eberlawrence/bebionic_rebuild/Componentes prótese - Atualizado._v2.xlsx

Sheet: Principal
Componente | Características | Encapsulamento | Código | Posição | Quantidade | Quant. Total | Valor Unit. | Valor Total | Link | Total | $56.81479 | R$328.96
Microcontrolador | DSPIC33FJ128MC804 | 44-TQFP | DSPIC33FJ128MC804-I/PT | U4 | 1 | 5 | $5.82000 | $5.82000 | https://www.digikey.com/products/en?keywords=DSPIC33FJ128MC804-I%2FPT
Driver de Potência | A3906SESTR-T | 20-QFN | A3906SESTR-T | U2 | 1 | 25 | $1.65000 | $1.65000 | https://www.digikey.com/product-detail/en/allegro-microsystems/A3906SESTR-T/620-1288-1-ND/2000019
Conversor DC-DC | 3.3V / 1.5A | 16-QFN | TPS62111RSAT | U1 | 1 | 5 | $2.31000 | $2.31000 | https://www.digikey.com/product-detail/en/texas-instruments/TPS62111RSAT/296-20670-1-ND/1133730
Regulador de tensão | 5V / 500mA | SOT-23-5 | MIC5219-5.0YM5-TR | U7, U8 | 2 | 5 | $0.89000 | $1.78000 | https://www.digikey.com/product-detail/en/microchip-technology/MIC5219-5-0YM5-TR/576-2770-1-ND/1821930
Isolador I2C | ADUM1250 | 8-SOIC | ADUM1250SRZ-RL7 | U3 | 1 | 5 | $6.60000 | $6.60000 | https://www.digikey.com/product-detail/en/analog-devices-inc/ADUM1250SRZ-RL7/ADUM1250SRZ-RL7CT-ND/4909611
Amplificador Operacional | MCP601T-I/OTCT-ND | SOT-23-5 | MCP601T-I/OT | U5 | 1 | 25 | $0.39000 | $0.39000 | https://www.digikey.com/product-detail/en/microchip-technology/MCP601T-I-OT/MCP601T-I-OTCT-ND/418616
Amplificador Operacional Dual Channel | MCP6002T-I/SNCT-ND | 8-MSOP | MCP6002T-I/MS | U6 | 1 | 5 | $0.33000 | $0.33000 | https://www.digikey.com/product-detail/en/microchip-technology/MCP6002T-I-MS/MCP6002T-I-MSCT-ND/669500
Bluetooth | v5.0 | Nonstandard | BL651 | U9 | 1 | 5 | $5.10000 | $5.10000 | https://www.digikey.com/product-detail/en/laird-wireless-thermal-systems/453-00006/453-00006CT-ND/9608593
Mosfet-N | Vds:20V / Vgs(th): 950mV / Rds:175mOhms / Id: 1.24A | SOT-23 | DMN2300U-7 | Q2, Q3 | 2 | 10 | $0.44000 | $0.88000 | https://www.digikey.com/products/en?keywords=DMN2300U-7DICT-ND
Mosfet-N - Vm Swiching | Vds:20V / Vgs(th): 1.2V / Rds:350mOhms / 750mA | SOT-723 | NTK3134NT1G | Q7 | 1 | 5 | $0.47000 | $0.47000 | https://www.digikey.com/products/en?keywords=NTK3134NT1GOSCT-ND
Mosfet-N Dual Channel | Vds:20V / Vgs(th): 1V / Rds:100mOhms / Id: 2A | SOT-23-6 | DMN2215UDM-7 | Q1 | 1 | 5 | $0.53000 | $0.53000 | https://www.digikey.com/products/en?keywords=DMN2215UDMDICT-ND
Mosfet-P - High current | Vds:30V / Vgs(th): 950mV / Rds:13mOhms / Id: 11A | 8-SOIC | FDS6675BZ | Q9, Q88 | 2 | 10 | $0.60000 | $1.20000 | https://www.digikey.com/products/en?keywords=FDS6675BZCT-ND
Mosfet-P Dual Channel | Vds:20V / Vgs(th): 1V / Rds:150mOhms / Id: 2A | SOT-23-6 | DMP2240UDM-7 | Q4, Q5 | 2 | 10 | $0.40000 | $0.80000 | https://www.digikey.com/products/en?keywords=DMP2240UDMDICT-ND
Diodo | BAT54HT1GOSCT-ND | SOD-323 | BAT54HT1G | D2 | 1 | 5 | $0.20000 | $0.20000 | https://www.digikey.com/product-detail/en/on-semiconductor/BAT54HT1G/BAT54HT1GOSCT-ND/917809
Diodo Zener | 3.3V | SOD-323F | BZT52C3V3LP-7 | D1, D3 | 2 | 10 | $0.20000 | $0.40000 | https://www.digikey.com/product-detail/en/on-semiconductor/MM3Z3V3B/MM3Z3V3BCT-ND/1626881
Diodo Zener | 8.51V | DO-219AC | PLZ9V1A-G3/H | D33 | 1 | 5 | $0.28000 | $0.28000 | https://www.digikey.com/product-detail/en/vishay-semiconductor-diodes-division/PLZ9V1A-G3-H/PLZ9V1A-G3-HGICT-ND/8031857
Indutor | 6,8uH | 0806 | SRN2009T-6R8M | L3 | 1 | 5 | $0.39000 | $0.39000 | https://www.digikey.com/product-detail/en/SRN2009T-6R8M/SRN2009T-6R8MCT-ND/7785089/?itemSeq=327671345
Ferrite Beads | 30 Ohms @ 100MHz | 0805 | BLM21SN300SH1D | L1 | 1 | 5 | $0.19000 | $0.19000 | https://www.digikey.com/product-detail/en/BLM21SN300SH1D/490-13265-1-ND/5881265/?itemSeq=327671346
Capacitor | 10pF - 10V | 0402 | C0402C100C8GACTU | C7 | 1 | 10 | $0.34000 | $0.34000 | https://www.digikey.com/product-detail/en/kemet/C0402C100C8GACTU/399-8939-1-ND/3522456
Capacitor | 470pF - 10V | 0402 | C0402C471K8RACTU | C23, C24 | 2 | 20 | $0.42000 | $0.84000 | https://www.digikey.com/product-detail/en/kemet/C0402C471K8RACTU/399-10036-1-ND/3739531
Capacitor | 0,1uF - 10V | 0402 | C0402C104M8PACTU | C1, C2, C3, C4, C6, C8, C9, C12, C14, C15, C21, C27, C11 | 13 | 200* | $0.10000 | $1.30000 | https://www.digikey.com/product-detail/en/kemet/C0402C104M8PACTU/399-7764-1-ND/3471487
Capacitor | 1uF - 25V | 0402 | GRM155C81C105KE11D | C13, C17, C25, C26, C32 | 5 | 50 | $0.26000 | $1.30000 | https://www.digikey.com/product-detail/en/murata-electronics/GRM155C81C105KE11D/490-12700-1-ND/5797669
Capacitor | 2,2uF - 10V | 0402 | GRM155C81A225KE44D | C34, C35 | 2 | 20 | $0.29000 | $0.58000 | https://www.digikey.com/product-detail/en/murata-electronics/GRM155C81A225KE44D/490-10442-1-ND/5026349
Capacitor | 10uF - 25V | 0805 | GRM21BC81E106KE51K | C7, C10, C16, C20, C31 | 5 | 100* | $0.47000 | $2.35000 | https://www.digikey.com/product-detail/en/murata-electronics/GRM21BC81E106KE51K/490-16325-1-ND/7363307
Capacitor | 22uF - 10V | 0805 | GRT21BC81A226ME13L | C30 | 1 | 10 | $0.63000 | $0.63000 | https://www.digikey.com/product-detail/en/murata-electronics/GRT21BC81A226ME13L/490-12342-1-ND/5417043
Resistor | 33mOhms / 1% / 0,5W | 0805 | ERJ-6BWFR033V | R1 | 1 | 50 | $0.63000 | $0.63000 | https://www.digikey.com/product-detail/en/panasonic-electronic-components/ERJ-6BWFR033V/P-033AQCT-ND/1466383
Resistor | 100Ohms / 1% / 0,2W | 0402 | CRCW0402100RFKEDHP | R26 | 1 | 10 | $0.14000 | $0.14000 | https://www.digikey.com/product-detail/en/vishay-dale/CRCW0402100RFKEDHP/541-100YCT-ND/2223026
Resistor | 120Ohms / 1% / 0,2W | 0402 | ERJ-PA2F1200X | R7, R15 | 2 | 20 | $0.21000 | $0.42000 | https://www.digikey.com/product-detail/en/panasonic-electronic-components/ERJ-PA2F1200X/P124432CT-ND/10271408
Resistor | 470Ohms / 1% / 0,2W | 0402 | CRCW0402470RFKEDHP | R36 | 1 | 10 | $0.14000 | $0.14000 | https://www.digikey.com/product-detail/en/vishay-dale/CRCW0402470RFKEDHP/541-2938-1-ND/2825968
Resistor | 1KOhms / 1% / 0,2W | 0402 | RCS04021K00FKED | R3, R28, R37 | 3 | 30 | $0.11000 | $0.33000 | https://www.digikey.com/product-detail/en/vishay-dale/RCS04021K00FKED/541-2888-1-ND/5867181
Resistor | 2.2KOhms / 1% / 0,2W | 0402 | CRCW04022K20FKEDHP | R50 | 1 | 10 | $0.14000 | $0.14000 | https://www.digikey.com/product-detail/en/vishay-dale/CRCW04022K20FKEDHP/541-2-20KYCT-ND/5326785
Resistor | 4.7KOhms / 1% / 0,2W | 0402 | CRCW04024K70FKEDHP | R2, R8, R9, R11, R14, R34 | 6 | 100 | $0.14000 | $0.84000 | https://www.digikey.com/product-detail/en/vishay-dale/CRCW04024K70FKEDHP/541-4-70KYCT-ND/2223036
Resistor | 10KOhms / 1% / 0,2W | 0402 | CRCW040210K0FKEDHP | R6, R18, R27, R29, R30, R32, R33, R35, R42, R43, R44, R51, R54, R56, R57 | 15 | 400 | $0.14000 | $2.10000 | https://www.digikey.com/product-detail/en/vishay-dale/CRCW040210K0FKEDHP/541-10-0KYCT-ND/2223041
Resistor | 18KOhms / 1% / 0,2W | 0402 | CRCW040218K0FKEDHP | R10 | 1 | 100* | $0.14000 | $0.14000 | https://www.digikey.com/product-detail/en/vishay-dale/CRCW040218K0FKEDHP/CRCW040218K0FKEDHPCT-ND/2825955
Resistor | 27KOhms / 1% / 0,2W | 0402 | CRCW040227K0FKEDHP | R40, R41 | 2 | 20 | $0.14000 | $0.28000 | https://www.digikey.com/product-detail/en/vishay-dale/CRCW040227K0FKEDHP/541-CRCW040227K0FKEDHPCT-ND/11501115
Resistor | 39KOhms / 1% / 0,2W | 0402 | RCS040239K0FKED | R55 | 1 | 10 | $0.11000 | $0.11000 | https://www.digikey.com/product-detail/en/vishay-dale/RCS040239K0FKED/541-10406-1-ND/10059772
Resistor | 100KOhms / 1% / 0,2W | 0402 | CRCW0402100KFKEDHP | R46, R58 | 2 | 20 | $0.14000 | $0.28000 | https://www.digikey.com/product-detail/en/vishay-dale/CRCW0402100KFKEDHP/541-100KYCT-ND/2223051
Resistor | 191KOhms / 0,1% / 0,1W | 0402 | RP73PF1E191KBTD | R5 | 1 | 100* | $0.58000 | $0.58000 | https://www.digikey.com/product-detail/en/te-connectivity-passive-product/RP73PF1E191KBTD/A127538CT-ND/8261504
Resistor | 1MOhms / 1% / 0,2W | 0402 | CRCW04021M00FKEDHP | R49 | 1 | 10 | $0.14000 | $0.14000 | https://www.digikey.com/product-detail/en/vishay-dale/CRCW04021M00FKEDHP/541-1-00MYCT-ND/2224560
Conector F. | NSHR-02V-S |  |  | J5, J6, J10 | 3 |  | $0.17000 | $0.51000 | https://www.digikey.com/products/en?keywords=NSHR-02V-S
Conector F. | NSHR-06V-S |  |  | J1, J2, J3, J4, J7, J9 | 6 |  | $0.24000 | $1.44000 | https://www.digikey.com/products/en?keywords=NSHR-06V-S
Conector F. | NSHR-04V-S |  |  | J8 | 1 |  | $0.21000 | $0.21000 | https://www.digikey.com/product-detail/en/jst-sales-america-inc/NSHR-04V-S/455-2790-ND/3313614
Conector M. | SM02B-NSHSS-TB |  |  | J5, J6, J10 | 3 |  | $0.36525 | $1.09575 | https://www.digikey.com/product-detail/en/jst-sales-america-inc/SM02B-NSHSS-TB-LF-SN/455-2776-2-ND/3313627
Conector M. | SM06B-NSHSS-TB (LF)(SN) |  |  | J1, J4, J7, J9 | 4 |  | $0.93000 | $3.72000 | https://www.digikey.com/product-detail/en/jst-sales-america-inc/SM06B-NSHSS-TB-LF-SN/455-2772-1-ND/3313667
Conector M. | SM04B-NSHSS-TB (LF)(SN) |  |  | J8 | 1 |  | $0.87000 | $0.87000 | https://www.digikey.com/product-detail/en/jst-sales-america-inc/SM04B-NSHSS-TB-LF-SN/455-2774-1-ND/3313665
Conector M. | BM06B-NSHSS-TBT (LF)(SN) |  |  | J2, J3 | 2 |  | $0.48952 | $0.97904 | https://www.digikey.com/product-detail/en/jst-sales-america-inc/BM06B-NSHSS-TBT-LF-SN/455-2758-2-ND/3313646
Terminal C. | SSHL-003T-P0.2 |  |  | J1, J2, J3, J4, J5, J6, J7, J8, J9, J10 | 46 |  | $0.11000 | $5.06000 | https://www.digikey.com/product-detail/en/jst-sales-america-inc/SSHL-003T-P0-2/455-2792-1-ND/3313668

Sheet: Novos conectores
Conector M. | 5015680207 | 2 pins | J5, J6, J10 | 3 | $0.51000 | $1.53000 | https://www.digikey.com/product-detail/en/molex/5015680207/WM7893CT-ND/1531543
Conector M. | 5015680607 | 6 pins | J1, J2, J3, J4, J7, J9 | 6 | $0.77000 | $4.62000 | https://www.digikey.com/product-detail/en/molex/5015680607/WM7897CT-ND/1531547
Conector M. | 5015680407 | 4 pins | J8 | 1 | $0.55000 | $0.55000 | https://www.digikey.com/product-detail/en/molex/5015680407/WM7895CT-ND/1531545
Conector F. | 5013300200 | 2 pins | J5, J6, J10 | 3 | $0.27000 | $0.81000 | https://www.digikey.com/products/en?keywords=5013300200
Conector F. | 5013300400 | 4 pins | J8 | 1 | $0.27000 | $0.27000 | https://www.digikey.com/product-detail/en/molex/5013300400/WM7917-ND/1531501
Conector F. | 5013300600 | 6 pins | J1, J2, J3, J4, J7, J9 | 6 | $0.29000 | $1.74000 | https://www.digikey.com/products/en?keywords=5013300600
Terminal | 5013340100 |  | J1, J2, J3, J4, J5, J6, J7, J8, J9, J10 | 46 | $0.11000 | $5.06000 | https://www.digikey.com/product-detail/en/molex/5013340100/WM7933-ND/1531513

Sheet: Motor
Componente | Espe | Encapsulamento | Código | Posição | Quantidade | Valor Unit. | Valor Total | Link | Total | $10.00000 | R$57.90
Microcontrolador | DSPIC33FJ32MC202 | 28-QFN-S | DSPIC33FJ32MC202T-I/MM | U1 | 1 | $3.78000 | $3.78000 | https://www.digikey.com/products/en/integrated-circuits-ics/embedded-microcontrollers/685?k=DSPIC33FJ32MC202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
Driver de Potência | A3906SESTR-T | 20-QFN | A3906SESTR-T | U2 | 1 | $1.65000 | $1.65000 | https://www.digikey.com/product-detail/en/allegro-microsystems/A3906SESTR-T/620-1288-1-ND/2000019
Amplificador Operacional | MCP601T-I/OTCT-ND | SOT-23-5 | MCP601T-I/OT | U3 | 1 | $0.39000 | $0.39000 | https://www.digikey.com/product-detail/en/microchip-technology/MCP601T-I-OT/MCP601T-I-OTCT-ND/418616
Capacitor | 10uF - 25V | 0805 | GRM21BC81E106KE51K | C6, C7 | 2 | $0.47000 | $0.94000 | https://www.digikey.com/product-detail/en/murata-electronics/GRM21BC81E106KE51K/490-16325-1-ND/7363307
Capacitor | 0,1uF - 10V | 0402 | C0402C104M8PACTU | C1, C2, C5, C6, C9, C10, C11, C12, C13, C14, C15 | 13 | $0.10000 | $1.30000 | https://www.digikey.com/product-detail/en/kemet/C0402C104M8PACTU/399-7764-1-ND/3471487
Resistor | 33mOhms / 1% / 0,5W | 0805 | ERJ-6BWFR033V | R6 | 1 | $0.63000 | $0.63000 | https://www.digikey.com/product-detail/en/panasonic-electronic-components/ERJ-6BWFR033V/P-033AQCT-ND/1466383
Resistor | 4.7KOhms / 1% / 0,2W | 0402 | CRCW04024K70FKEDHP | R7 | 1 | $0.14000 | $0.14000 | https://www.digikey.com/product-detail/en/vishay-dale/CRCW04024K70FKEDHP/541-4-70KYCT-ND/2223036
Resistor | 10KOhms / 1% / 0,2W | 0402 | CRCW040210K0FKEDHP | R1, R2, R5, R18, R30 | 5 | $0.14000 | $0.70000 | https://www.digikey.com/product-detail/en/vishay-dale/CRCW040210K0FKEDHP/541-10-0KYCT-ND/2223041
Resistor | 18KOhms / 1% / 0,2W | 0402 | CRCW040218K0FKEDHP | R4 | 1 | $0.14000 | $0.14000 | https://www.digikey.com/product-detail/en/vishay-dale/CRCW040218K0FKEDHP/CRCW040218K0FKEDHPCT-ND/2825955
Resistor | 191KOhms / 0,1% / 0,1W | 0402 | RP73PF1E191KBTD | R3 | 1 | $0.58000 | $0.58000 | https://www.digikey.com/product-detail/en/te-connectivity-passive-product/RP73PF1E191KBTD/A127538CT-ND/8261504
Conector F. | NSHR-06V-S |  |  | J1, J2 | 2 | $0.24000 | $0.48000 | https://www.digikey.com/products/en?keywords=NSHR-06V-S
Conector F. | NSHR-04V-S |  |  | J3 | 1 | $0.21000 | $0.21000 | https://www.digikey.com/product-detail/en/jst-sales-america-inc/NSHR-04V-S/455-2790-ND/3313614
Conector M. | SM06B-NSHSS-TB (LF)(SN) |  |  | J1, J2 | 2 | $0.93000 | $1.86000 | https://www.digikey.com/product-detail/en/jst-sales-america-inc/SM06B-NSHSS-TB-LF-SN/455-2772-1-ND/3313667
Conector M. | SM04B-NSHSS-TB (LF)(SN) |  |  | J3 | 1 | $0.87000 | $0.87000 | https://www.digikey.com/product-detail/en/jst-sales-america-inc/SM04B-NSHSS-TB-LF-SN/455-2774-1-ND/3313665
Terminal C. | SSHL-003T-P0.2 |  |  | J1, J2, J3 | 16 | $0.11000 | $1.76000 | https://www.digikey.com/product-detail/en/jst-sales-america-inc/SSHL-003T-P0-2/455-2792-1-ND/3313668
