eberlawrence/bebionic_rebuild/bebionic_shc-brd/Placa_Motor_Protese (1).pdf

A

A

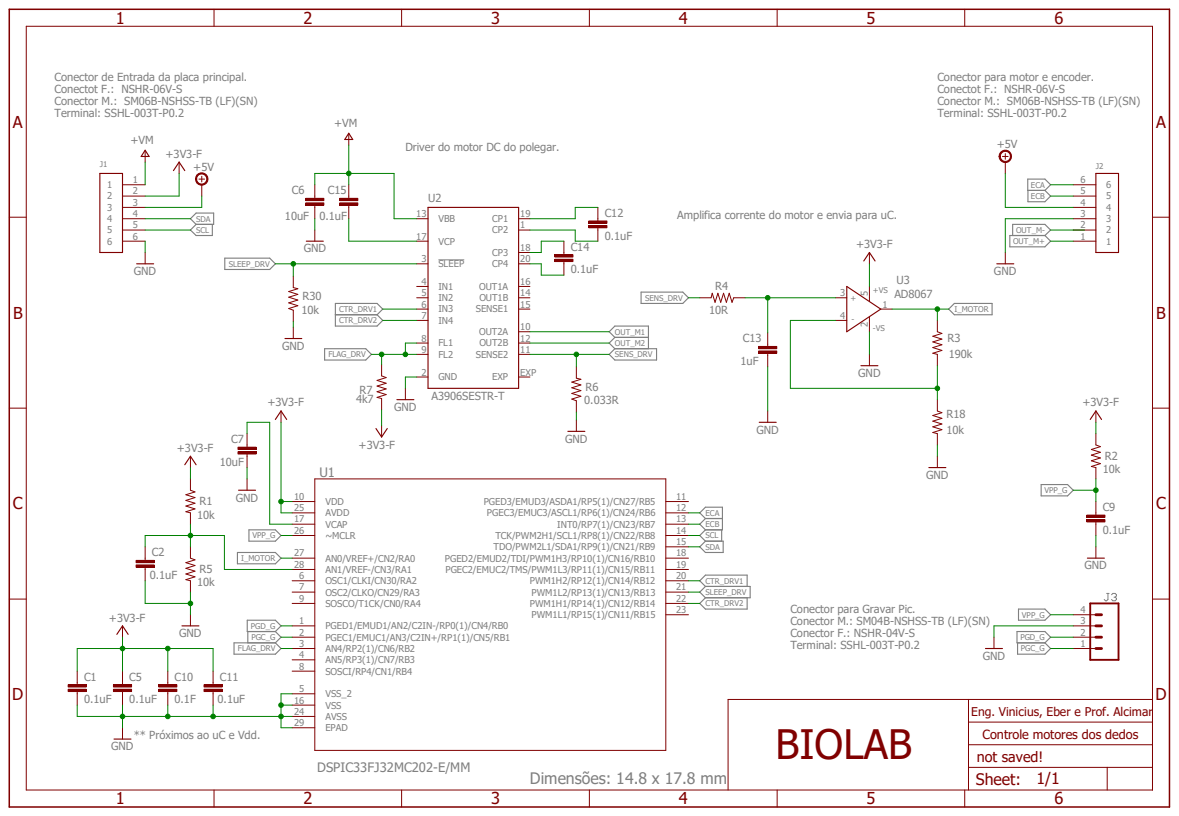
[picture p8: page 1]

Conector de Entrada da placa principal.
Conectot F.: NSHR-06V-S
Conector M.: SM06B-NSHSS-TB (LF)(SN)
Terminal: SSHL-003T-P0.2

Conector para motor e encoder.

Driver do motor DC do polegar.

Amplifica corrente do motor e envia para uC.

Conector para Gravar Pic.
Conector M.: SM04B-NSHSS-TB (LF)(SN)
Conector F.: NSHR-04V-S
BIOLAB

Eng. Vinicius, Eber e Prof. Alcimar
Controle motores dos dedos
not saved!
Sheet:

** Próximos ao uC e Vdd.
GND
