eberlawrence/bebionic_rebuild/bebionic_shc-brd/finger_circuit.pdf

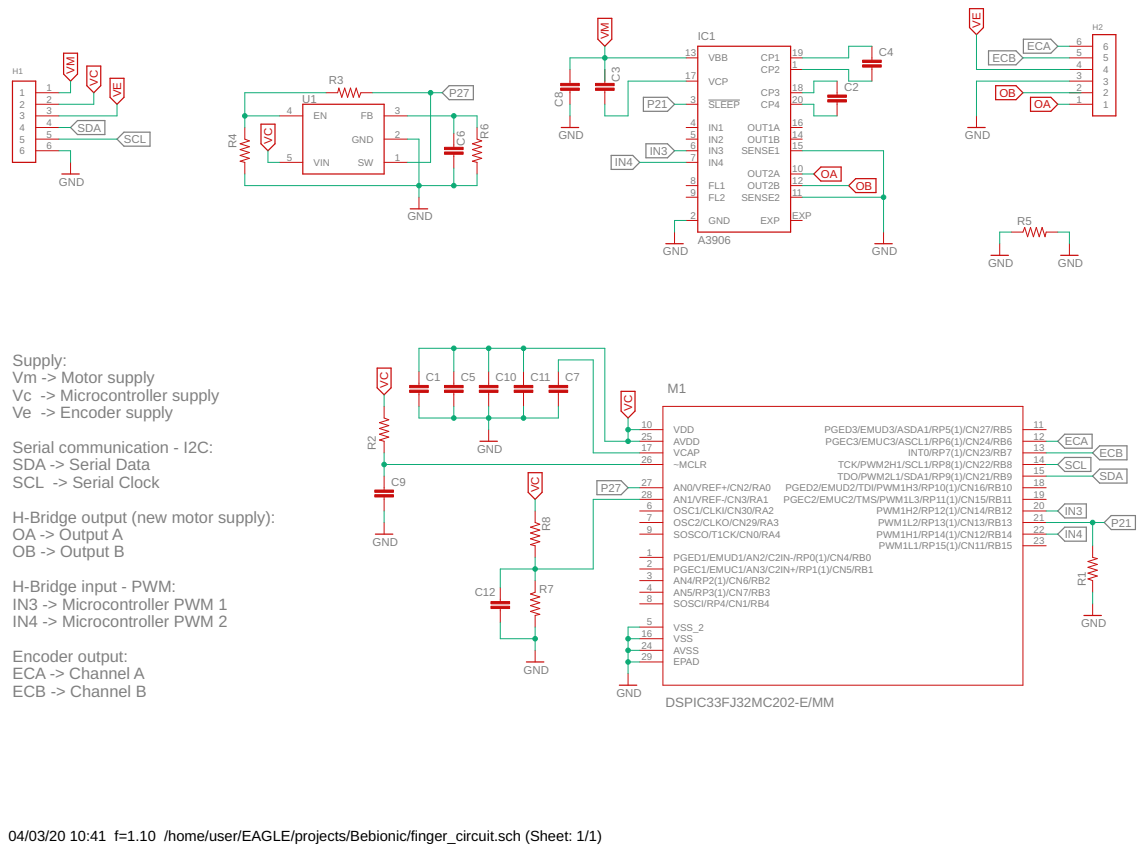
[picture p9: page 1]

H-Bridge output (new motor supply):
OA -> Output A
OB -> Output B

04/03/20 10:41 f=1.10 /home/user/EAGLE/projects/Bebionic/finger_circuit.sch (Sheet: 1/1)
