eberlawrence/bebionic_rebuild/bebionic_shc-brd/main_circuit.pdf

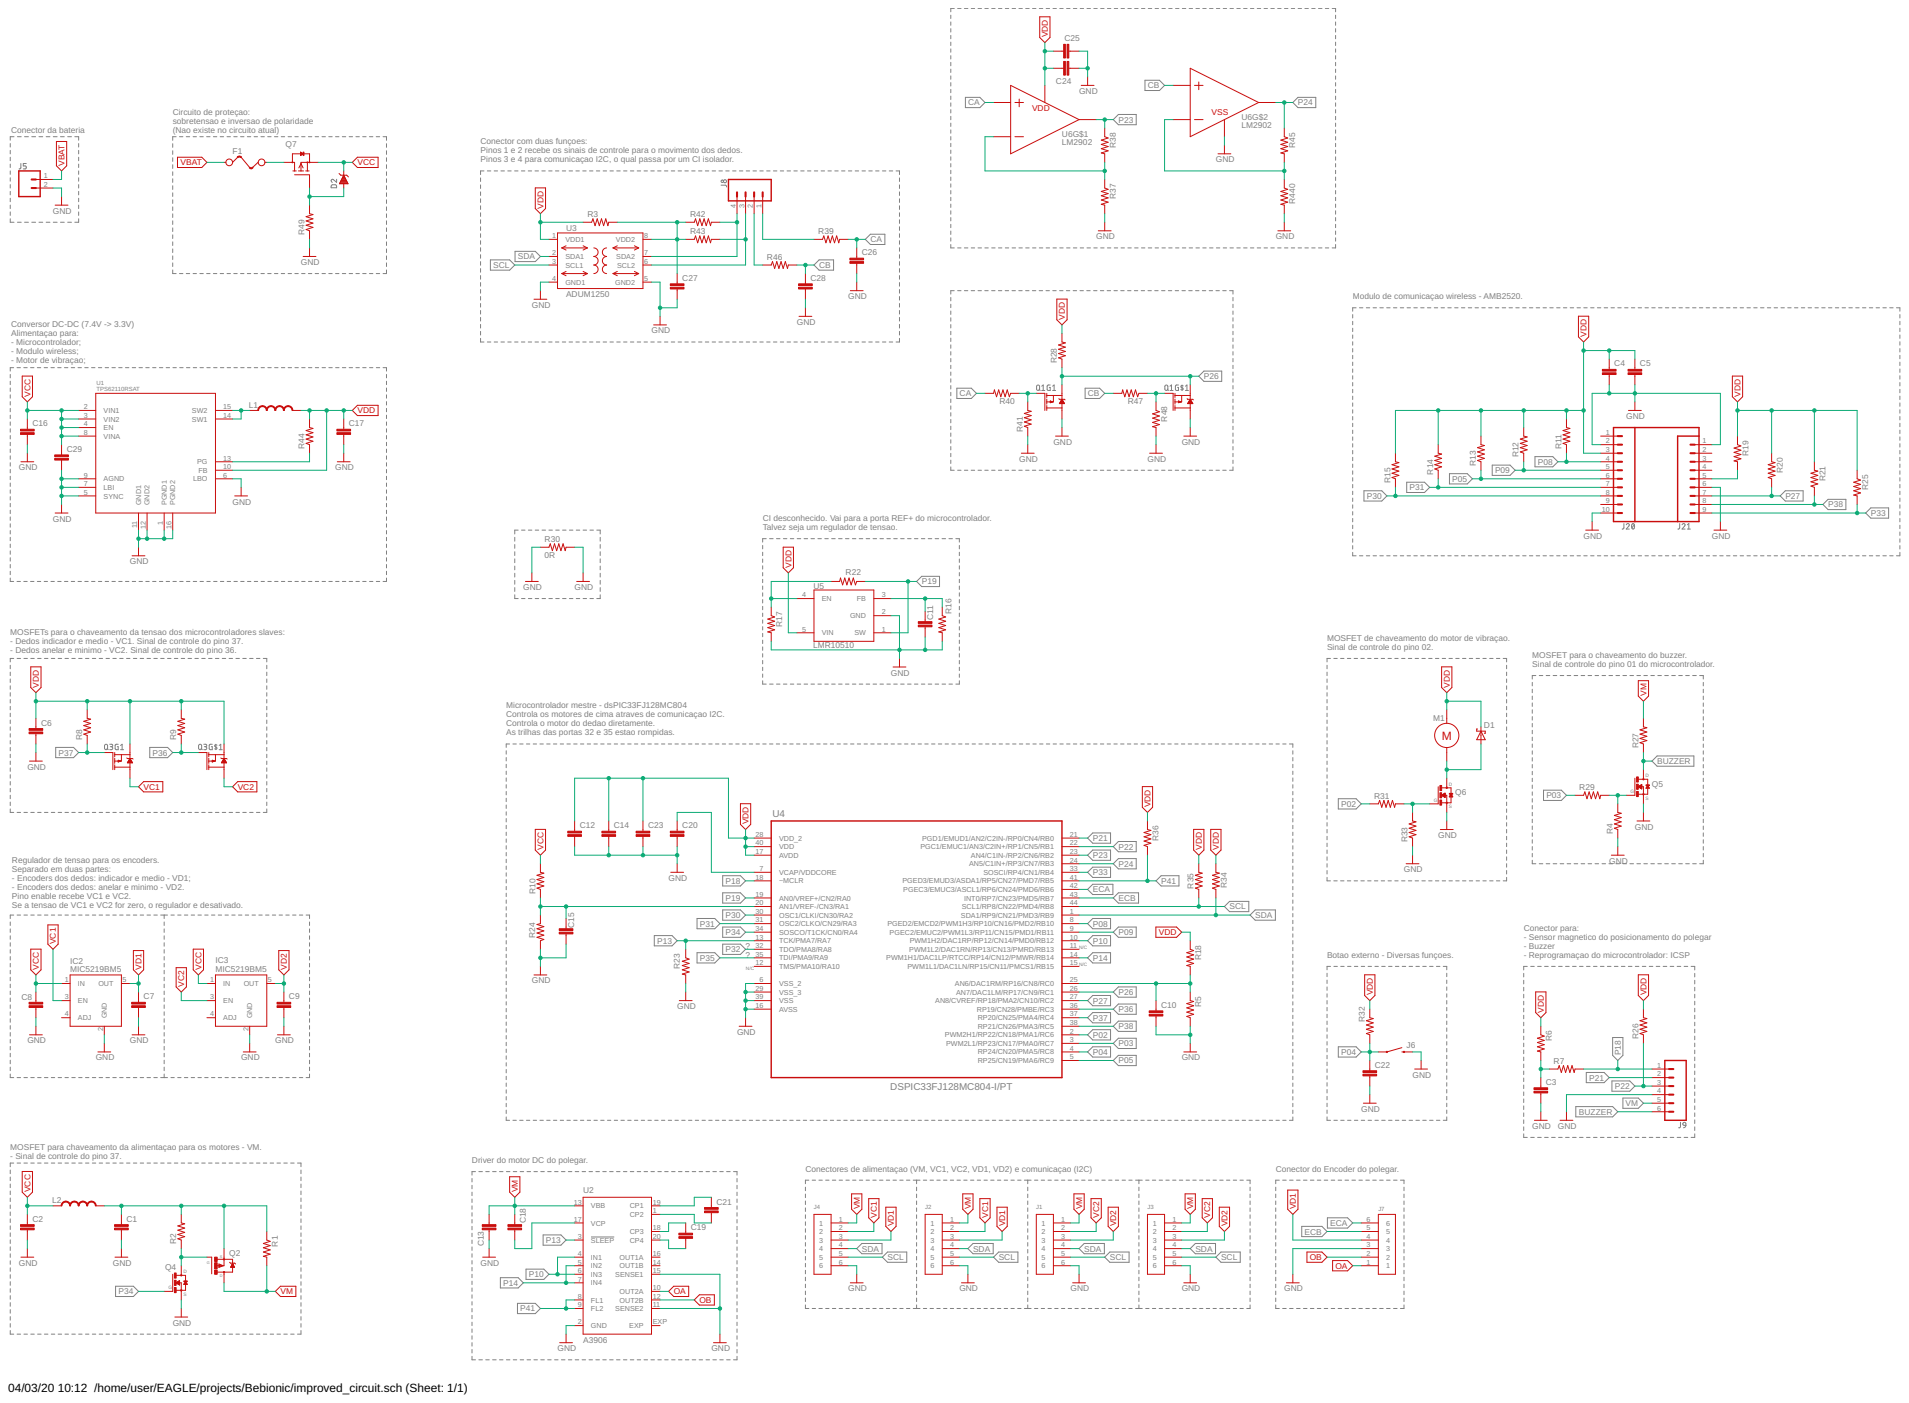
[picture p10: page 1]

(Nao existe no circuito atual)

Conector com duas funçoes: Pinos 1 e 2 recebe os sinais de controle para o movimento dos dedos. Pinos 3 e 4 para comunicaçao I2C, o qual passa por um CI isolador.

Modulo de comunicaçao wireless - AMB2520.

Conversor DC-DC (7.4V -> 3.3V)
Alimentaçao para: - Microcontrolador; - Modulo wireless; - Motor de vibraçao;

CI desconhecido. Vai para a porta REF+ do microcontrolador. Talvez seja um regulador de tensao.

MOSFETs para o chaveamento da tensao dos microcontroladores slaves: - Dedos indicador e medio - VC1. Sinal de controle do pino 37. - Dedos anelar e minimo - VC2. Sinal de controle do pino 36.

MOSFET de chaveamento do motor de vibraçao. Sinal de controle do pino 02.

MOSFET para o chaveamento do buzzer. Sinal de controle do pino 01 do microcontrolador.

Microcontrolador mestre - dsPIC33FJ128MC804
Controla os motores de cima atraves de comunicaçao I2C. Controla o motor do dedao diretamente. As trilhas das portas 32 e 35 estao rompidas.

Regulador de tensao para os encoders. Separado em duas partes: - Encoders dos dedos: indicador e medio - VD1; - Encoders dos dedos: anelar e minimo - VD2. Pino enable recebe VC1 e VC2. Se a tensao de VC1 e VC2 for zero, o regulador e desativado.

P31 | P08
P34 | P09

Conector para: - Sensor magnetico do posicionamento do polegar
- Buzzer
- Reprogramaçao do microcontrolador: ICSP

Botao externo - Diversas funçoes.

MOSFET para chaveamento da alimentaçao para os motores - VM. - Sinal de controle do pino 37.

Driver do motor DC do polegar.

04/03/20 10:12 /home/user/EAGLE/projects/Bebionic/improved_circuit.sch (Sheet: 1/1)
