eberlawrence/bebionic_rebuild/bebionic_shc-brd/Placa_Main_Protese (1).pdf

# FDN352AP12k

A

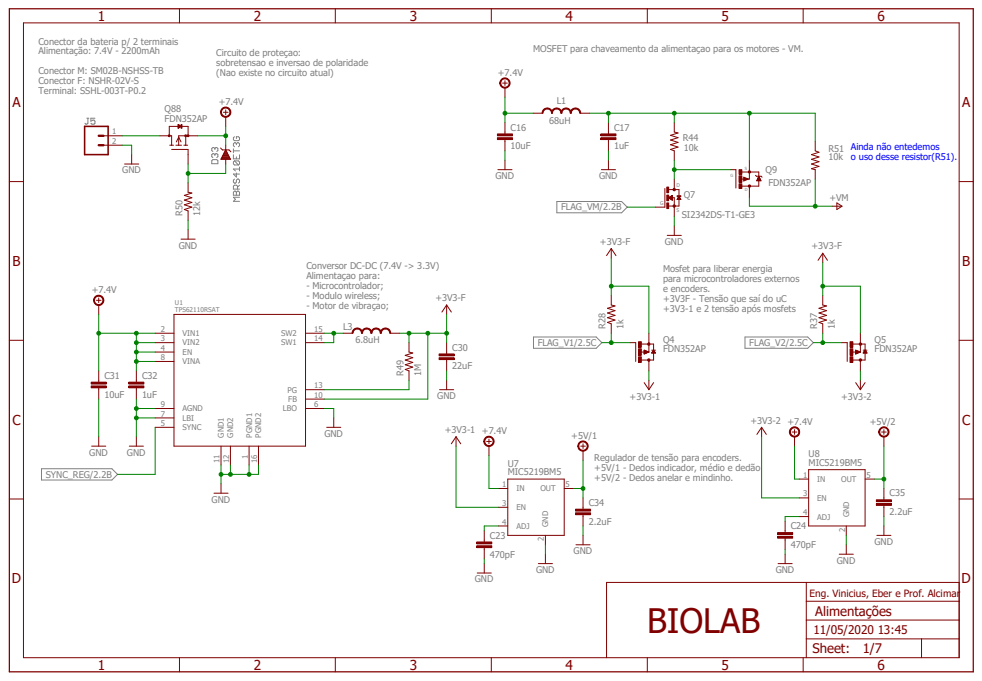
[picture p11: page 1]

Conector da bateria p/ 2 terminais
Alimentação: 7.4V - 2200mAh
Conector M: SM02B-NSHSS-TB
Conector F: NSHR-02V-S
Terminal: SSHL-003T-P0.2

Circuito de proteçao:
sobretensao e inversao de polaridade
(Nao existe no circuito atual)

MOSFET para chaveamento da alimentaçao para os motores - VM.

Mosfet para liberar energia
para microcontroladores externos
e encoders.
+3V3F - Tensão que saí do uC
+3V3-1 e 2 tensão após mosfets

Regulador de tensão para encoders.
+5V/1 - Dedos indicador, médio e dedão
+5V/2 - Dedos anelar e mindinho.

A

A

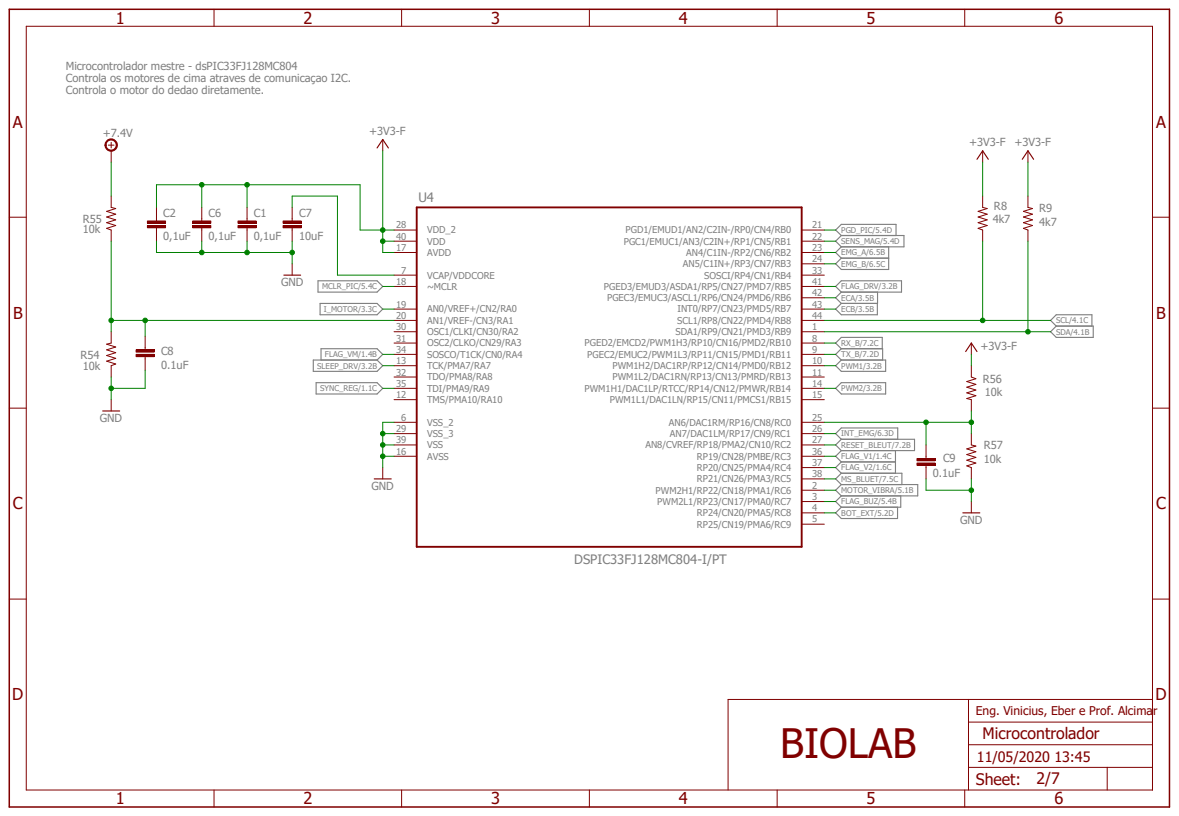
[picture p12: page 2]

Microcontrolador mestre - dsPIC33FJ128MC804
Controla os motores de cima atraves de comunicaçao I2C.
Controla o motor do dedao diretamente.

A

A

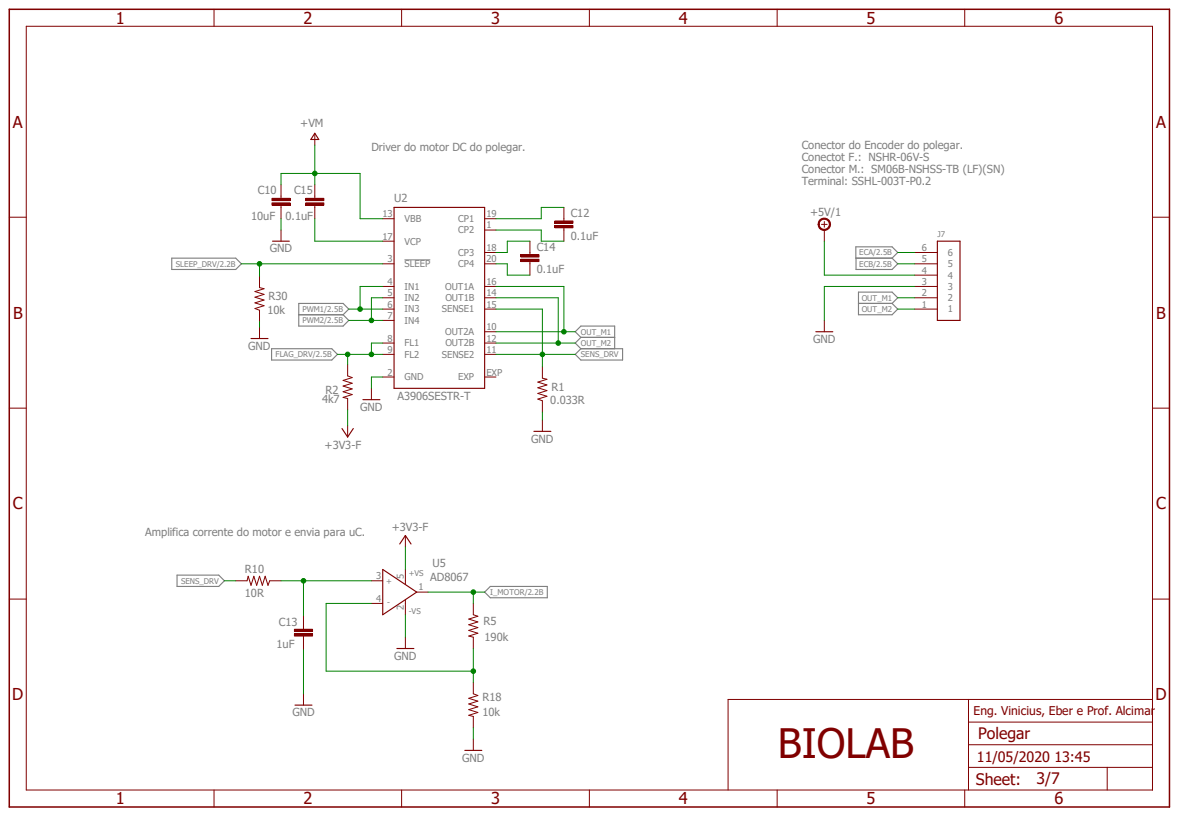
[picture p13: page 3]

Conectot F.: NSHR-06V-S
Conector M.: SM06B-NSHSS-TB (LF)(SN)
Terminal: SSHL-003T-P0.2

Amplifica corrente do motor e envia para uC.

A

A

Saída Dedo indicador; Saída Dedo Médio; Saída Dedo Anelar; Saída Dedo Mindinho; GND; SCL/6.1B; SDA/6.1B; BIOLAB

Conector dos dedos.
Conectot F.: NSHR-06V-S
Conector M.: SM06B-NSHSS-TB (LF)(SN)
Terminal: SSHL-003T-P0.2

Eng. Vinicius, Eber e Prof. Alcimar
Demais dedos
Sheet:

A

A

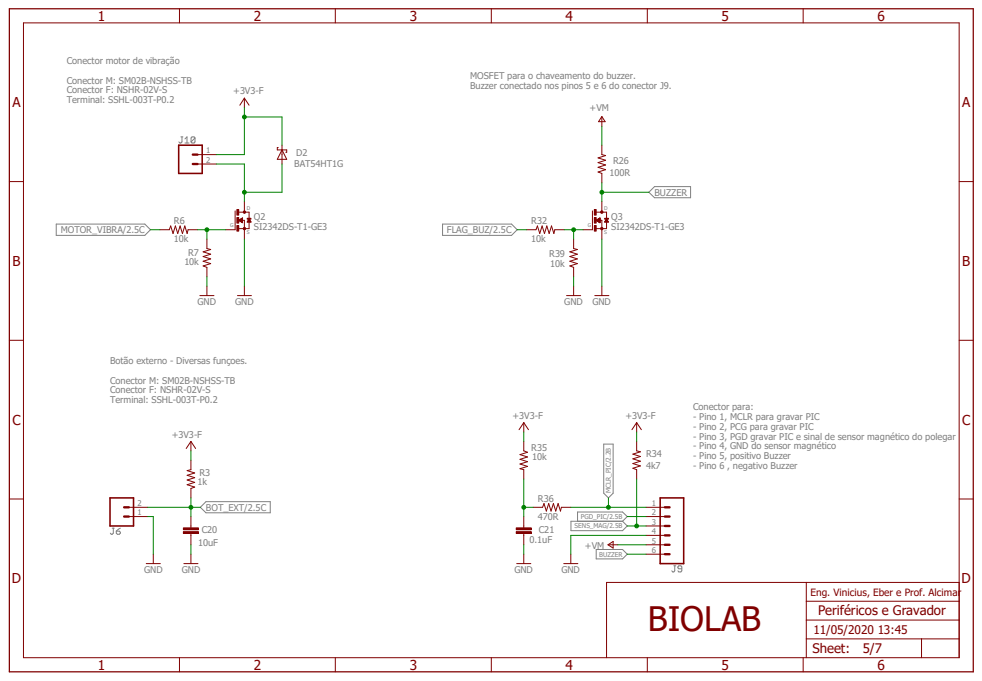
[picture p14: page 5]

Conector motor de vibração
Conector M: SM02B-NSHSS-TB
Conector F: NSHR-02V-S
Terminal: SSHL-003T-P0.2

MOSFET para o chaveamento do buzzer.
Buzzer conectado nos pinos 5 e 6 do conector J9.

Botão externo - Diversas funçoes.

- Pino 1, MCLR para gravar PIC
- Pino 2, PCG para gravar PIC
- Pino 3, PGD gravar PIC e sinal de sensor magnético do polegar
- Pino 4, GND do sensor magnético
- Pino 5, positivo Buzzer
- Pino 6 , negativo Buzzer

Eng. Vinicius, Eber e Prof. Alcimar
Periféricos e Gravador
Sheet:

A

A

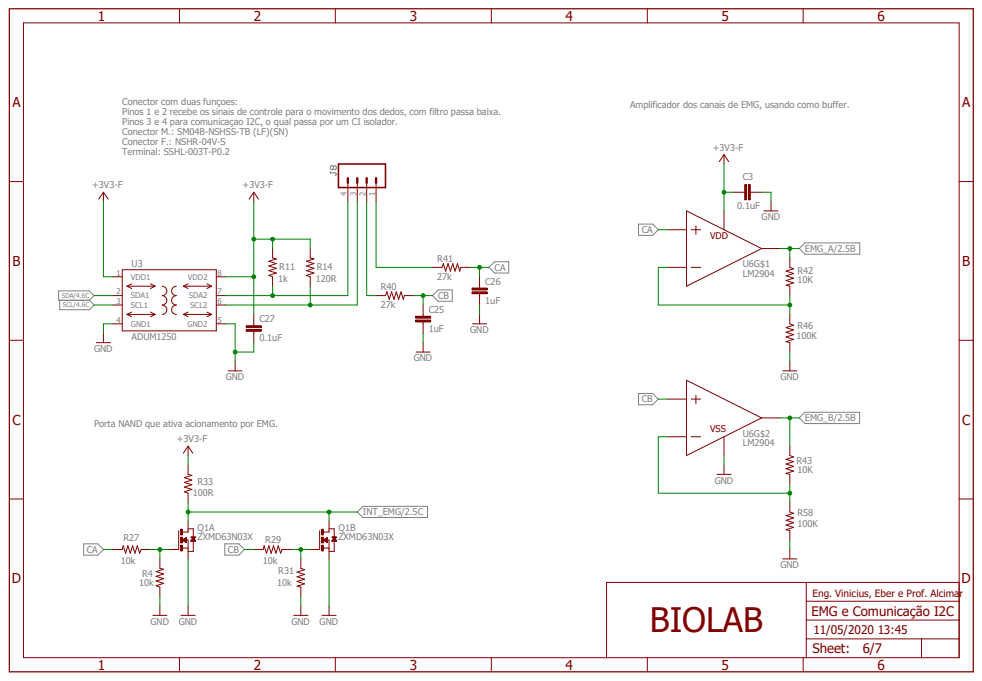
[picture p15: page 6]

Conector com duas funçoes:
Pinos 1 e 2 recebe os sinais de controle para o movimento dos dedos, com filtro passa baixa.
Pinos 3 e 4 para comunicaçao I2C, o qual passa por um CI isolador.
Conector M.: SM04B-NSHSS-TB (LF)(SN)
Conector F.: NSHR-04V-S
Terminal: SSHL-003T-P0.2

Amplificador dos canais de EMG, usando como buffer.

Porta NAND que ativa acionamento por EMG.

Eng. Vinicius, Eber e Prof. Alcimar
EMG e Comunicação I2C
Sheet:

A

A

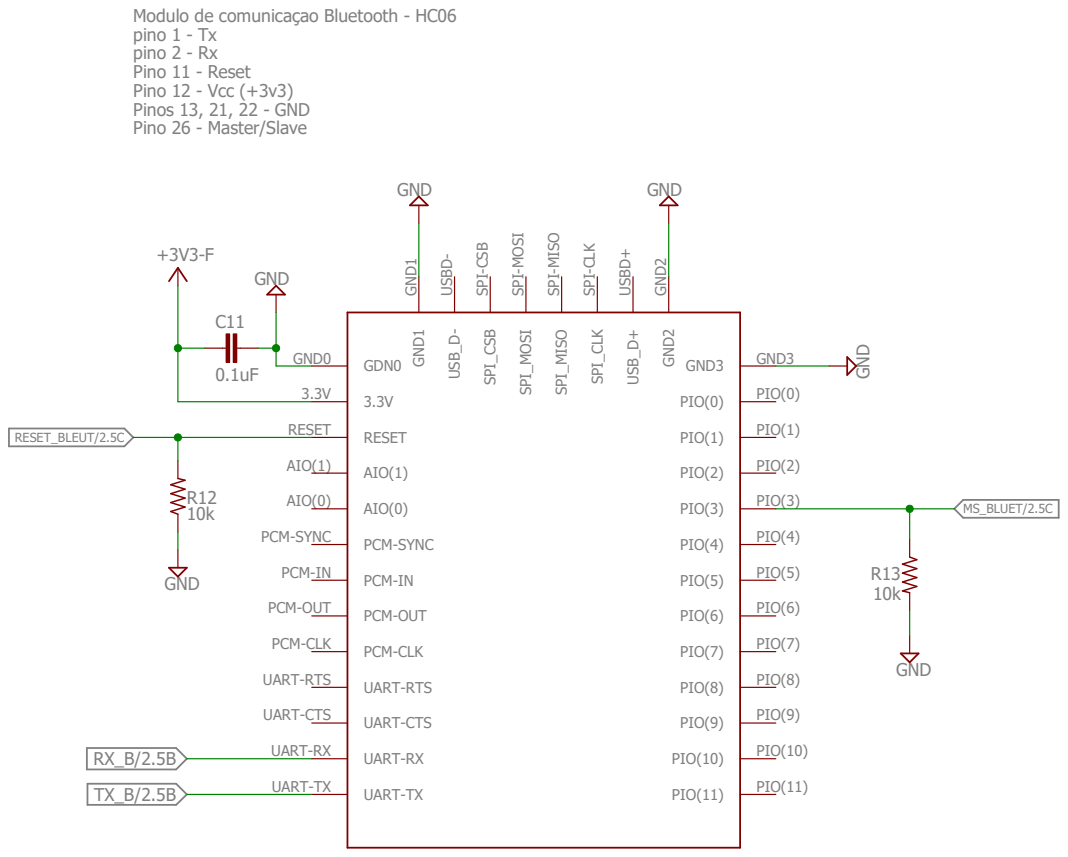
[picture p16: page 7]
GND; AIO(0) AIO(0); AIO(1) AIO(1); RESET RESET; GDN0 GND0; GND¹ GND¹; USB_D⁻ USBD⁻; SPI_CSB SPI-CSB; SPI_MOSI SPI-MOSI; SPI_MISO SPI-MISO; SPI_CLK SPI-CLK; USB_D+ USBD+; GND² GND²; GND3; PIO(0); PIO(1); PIO(2); PIO(3); PIO(4); PIO(5); PIO(6); PIO(7); PIO(8); PIO(9); PIO(10); PIO(11); RESET_BLEUT/2.5C; MS_BLUET/2.5C; BIOLAB

Modulo de comunicaçao Bluetooth - HC06
pino 1 - Tx
pino 2 - Rx
Pino 11 - Reset
Pino 12 - Vcc (+3v3)
Pinos 13, 21, 22 - GND
Pino 26 - Master/Slave

PCM-SYNC

PCM-IN

PCM-OUT

PCM-CLK

UART-RTS

UART-CTS

UART-RX

UART-TX

Eng. Vinicius, Eber e Prof. Alcimar
Bluetooth
Sheet:
