eberlawrence/bebionic_rebuild/(list of files, drawings)

Other design files:
bebionic_simulation/bebionic_simulation.pdsprj
bebionic_simulation/final_simulation.pdsprj
bebionic_simulation/only_master.pdsprj
bebionic_simulation/only_master_copy.pdsprj
