eberlawrence/bebionic_rebuild/Bebionic_Final_backup/placa_motor_v5.brd

## EAGLE design Bebionic_Final_backup/placa_motor_v5.brd (2021-04-02)

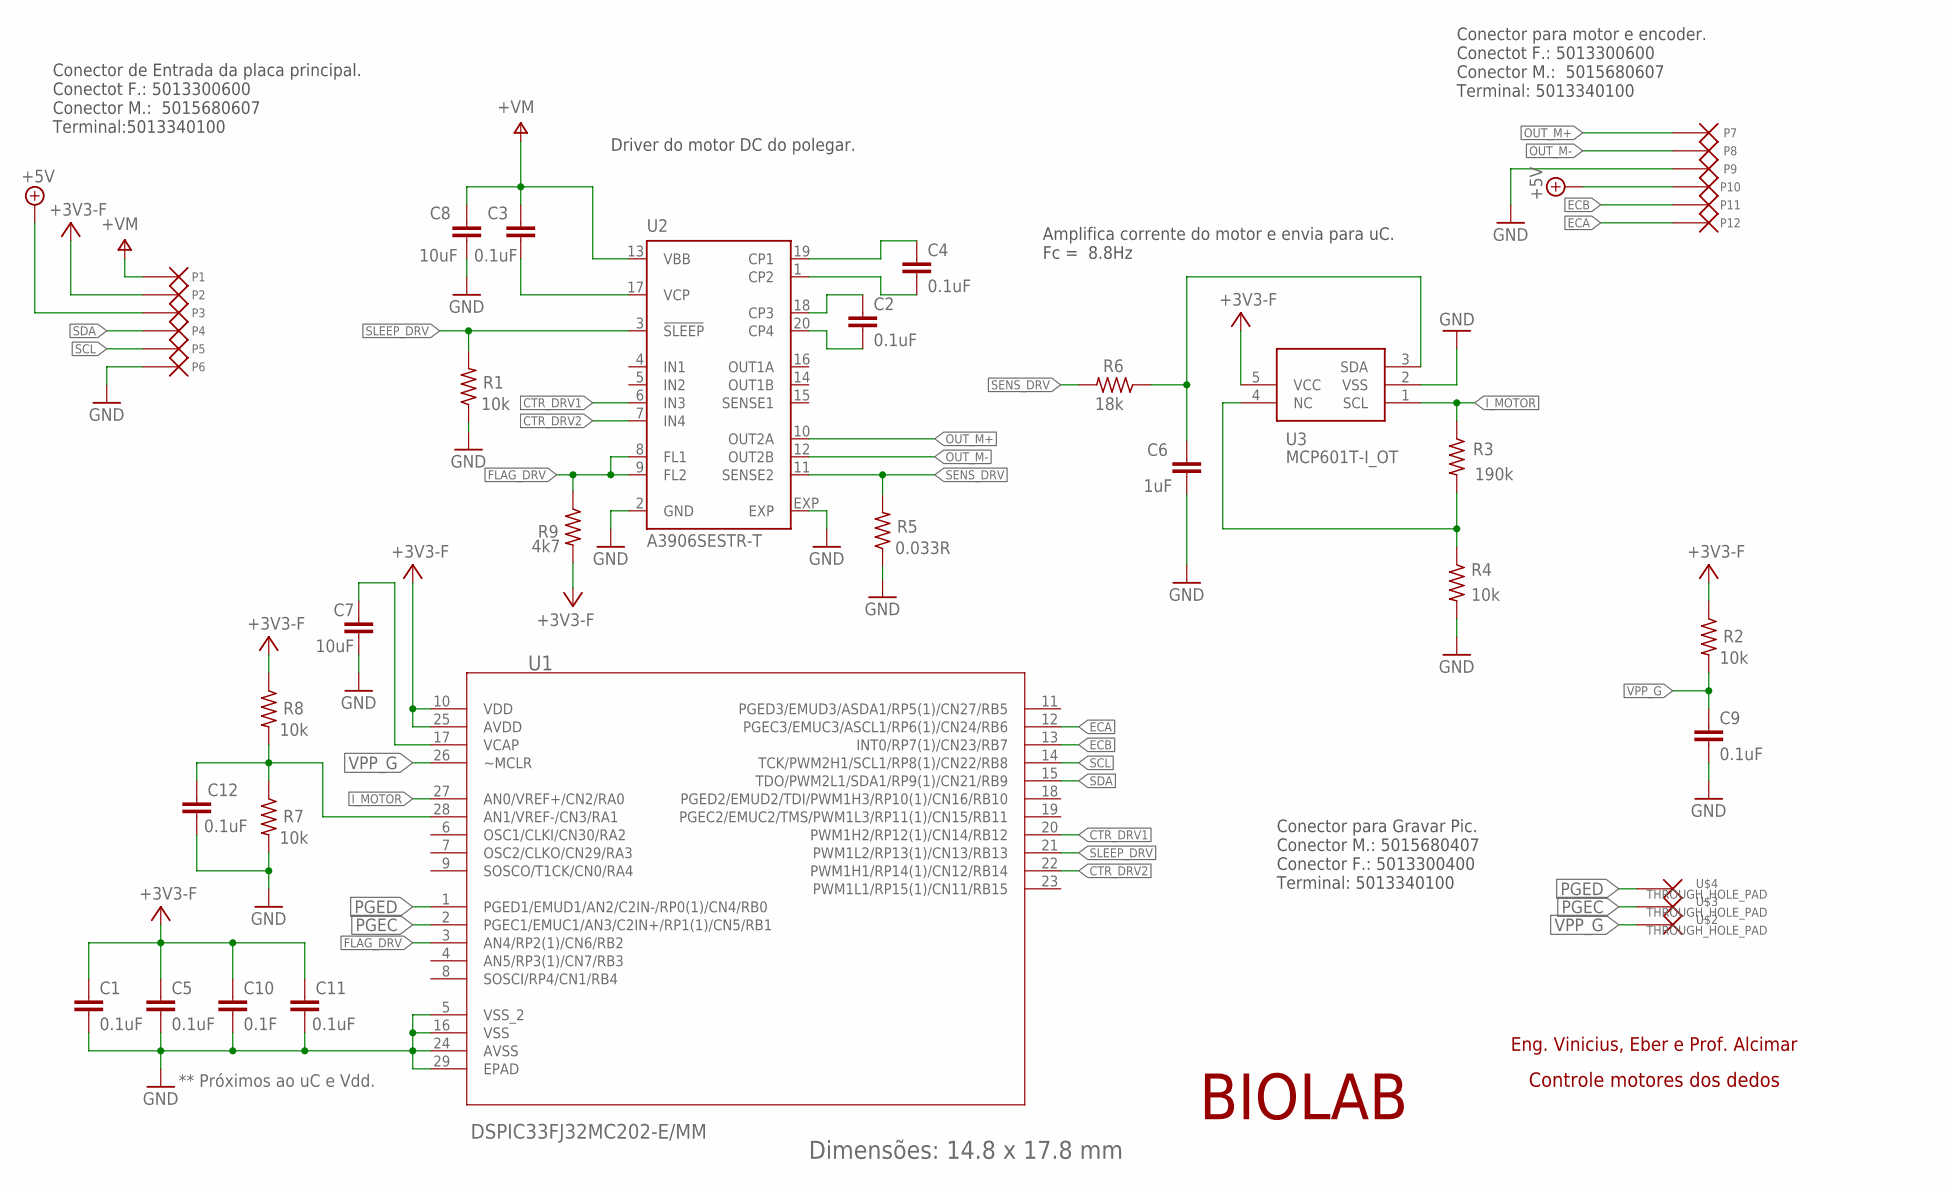
[picture p17: schematic placa_motor_v5.sch]

Parts:
C1, C2, C3, C4, C5, C9, C11, C12: 0.1uF; C0402K
C6: 1uF; C0402K
C7, C8: 10uF; C0805K
C10: 0.1F; C0402K
P1, P2, P3, P4, P5, P6, P7, P8, P9, P10, P11, P12: THROUGH_HOLE_PAD
R1, R2, R4, R7, R8: 10k; R0402
R3: 190k; R0402
R5: 0.033R; R0805
R6: 18k; R0402
R9: 4k7; R0402
U1: DSPIC33FJ32MC202-E/MM; QFN65P600X600X100-29N
U2: A3906SESTR-T; QFN20
U3: MCP601T-I_OT; SOT95P270X145-5N
U$2, U$3, U$4: THROUGH_HOLE_PAD

Connections:
+3V3: C1.1, C5.1, C10.1, C11.1, P2.P$1, R2.1, R8.1, R9.2, U1.10 (VDD), U1.25 (AVDD), U3.5 (VCC)
+5V: P3.P$1, P10.P$1
AUX: C12.1, R7.1, R8.2, U1.28 (AN1/VREF-/CN3/RA1)
CTR_DRV1: U1.20 (PWM1H2/RP12(1)/CN14/RB12), U2.6 (IN3)
CTR_DRV2: U1.22 (PWM1H1/RP14(1)/CN12/RB14), U2.7 (IN4)
ECA: P12.P$1, U1.12 (PGEC3/EMUC3/ASCL1/RP6(1)/CN24/RB6)
ECB: P11.P$1, U1.13 (INT0/RP7(1)/CN23/RB7)
FLAG_DRV: R9.1, U1.3 (AN4/RP2(1)/CN6/RB2), U2.8 (FL1), U2.9 (FL2)
GND: C1.2, C5.2, C6.2, C7.2, C8.1, C9.2, C10.2, C11.2, C12.2, P6.P$1, P9.P$1, R1.1, R4.2, R5.1, R7.2, U1.5 (VSS_2), U1.16 (VSS), U1.24 (AVSS), U1.29 (EPAD), U2.2 (GND), U2.EXP, U3.2 (VSS)
I_MOTOR: R3.1, U1.27 (AN0/VREF+/CN2/RA0), U3.1 (SCL)
N1: C7.1, U1.17 (VCAP)
N2: R3.2, R4.1, U3.4 (NC)
N3: C6.1, R6.1, U3.3 (SDA)
N4: C4.1, U2.19 (CP1)
N5: C4.2, U2.1 (CP2)
N6: C2.1, U2.18 (CP3)
N7: C2.2, U2.20 (CP4)
N8: C3.2, U2.17 (VCP)
OUT_M+: P7.P$1, U2.10 (OUT2A)
OUT_M-: P8.P$1, U2.12 (OUT2B)
PGEC: U1.2 (PGEC1/EMUC1/AN3/C2IN+/RP1(1)/CN5/RB1), U$3.P$1
PGED: U1.1 (PGED1/EMUD1/AN2/C2IN-/RP0(1)/CN4/RB0), U$4.P$1
SCL: P5.P$1, U1.14 (TCK/PWM2H1/SCL1/RP8(1)/CN22/RB8)
SDA: P4.P$1, U1.15 (TDO/PWM2L1/SDA1/RP9(1)/CN21/RB9)
SENS_DRV: R5.2, R6.2, U2.11 (SENSE2)
SLEEP_DRV: R1.2, U1.21 (PWM1L2/RP13(1)/CN13/RB13), U2.3 (!SLEEP)
V+: C3.1, C8.2, P1.P$1, U2.13 (VBB)
VPP_G: C9.1, R2.2, U1.26 (~MCLR), U$2.P$1

Notes on the sheet:
Dimensões: 14.8 x 17.8 mm
** Próximos ao uC e Vdd.
Conector para motor e encoder. Conectot F.: 5013300600 Conector M.: 5015680607 Terminal: 5013340100
Conector de Entrada da placa principal. Conectot F.: 5013300600 Conector M.: 5015680607 Terminal:5013340100
BIOLAB
Eng. Vinicius, Eber e Prof. Alcimar
Driver do motor DC do polegar.
Amplifica corrente do motor e envia para uC. Fc = 8.8Hz
Controle motores dos dedos
Conector para Gravar Pic. Conector M.: 5015680407 Conector F.: 5013300400 Terminal: 5013340100

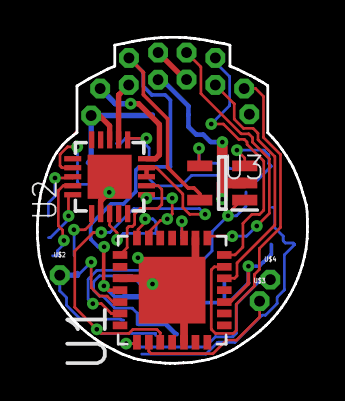
[picture p18: board placa_motor_v5.brd from above]

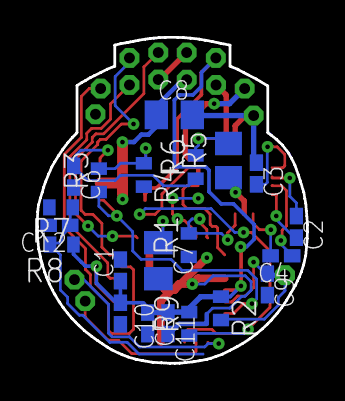
[picture p19: board placa_motor_v5.brd from below]

Board: 2 copper layers, 15.0 x 18.1 mm, 39 parts (22 on the bottom side), 28 nets.
