eberlawrence/bebionic_rebuild/bebionic_firmware/current_files/test_files/Main.c

/**********************************************************************
* © 2005 Microchip Technology Inc.
*
* FileName:        main.c
* Dependencies:    Header (.h) files if applicable, see below
* Processor:       dsPIC33Fxxxx/PIC24Hxxxx
* Compiler:        MPLAB® C30 v3.00 or higher
* Tested On:	   dsPIC33FJ256GP710
*
* SOFTWARE LICENSE AGREEMENT:
* Microchip Technology Incorporated ("Microchip") retains all ownership and 
* intellectual property rights in the code accompanying this message and in all 
* derivatives hereto.  You may use this code, and any derivatives created by 
* any person or entity by or on your behalf, exclusively with Microchip's
* proprietary products.  Your acceptance and/or use of this code constitutes 
* agreement to the terms and conditions of this notice.
*
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
* YOU ACKNOWLEDGE AND AGREE THAT, IN NO EVENT, SHALL MICROCHIP BE LIABLE, WHETHER 
* IN CONTRACT, WARRANTY, TORT (INCLUDING NEGLIGENCE OR BREACH OF STATUTORY DUTY), 
* STRICT LIABILITY, INDEMNITY, CONTRIBUTION, OR OTHERWISE, FOR ANY INDIRECT, SPECIAL, 
* PUNITIVE, EXEMPLARY, INCIDENTAL OR CONSEQUENTIAL LOSS, DAMAGE, FOR COST OR EXPENSE OF 
* ANY KIND WHATSOEVER RELATED TO THE CODE, HOWSOEVER CAUSED, EVEN IF MICROCHIP HAS BEEN 
* ADVISED OF THE POSSIBILITY OR THE DAMAGES ARE FORESEEABLE.  TO THE FULLEST EXTENT 
* ALLOWABLE BY LAW, MICROCHIP'S TOTAL LIABILITY ON ALL CLAIMS IN ANY WAY RELATED TO 
* THIS CODE, SHALL NOT EXCEED THE PRICE YOU PAID DIRECTLY TO MICROCHIP SPECIFICALLY TO 
* HAVE THIS CODE DEVELOPED.
*
* You agree that you are solely responsible for testing the code and 
* determining its suitability.  Microchip has no obligation to modify, test, 
* certify, or support the code.
*
* REVISION HISTORY:
*~~~~~~~~~~~~~~~~~~~~~~~~~~~~~~~~~~~~~~~~~~~~~~~~~~~~~~~~~~~~~~~~~~~~~~
* Author            	Date      Comments on this revision
*~~~~~~~~~~~~~~~~~~~~~~~~~~~~~~~~~~~~~~~~~~~~~~~~~~~~~~~~~~~~~~~~~~~~~~
* Pinakin K. Makwana	09/02/2007	  First release of source file
*~~~~~~~~~~~~~~~~~~~~~~~~~~~~~~~~~~~~~~~~~~~~~~~~~~~~~~~~~~~~~~~~~~~~~~
* ADDITIONAL NOTES: 
* This code is tested on Explorer 16 board with dsPIC33FJ256GP710
* Read "CE145_Readme.txt" file for more information on how to use this code example in your
* application.
**********************************************************************/

#if defined(__dsPIC33F__)
#include "p33Fxxxx.h"
#elif defined(__PIC24H__)
#include "p24Hxxxx.h"
#endif

#include "I2CSlaveDrv.h"	//Include file for I2C1 Driver

// Confiuration Register Settings
// Internal FRC Oscillator
_FOSCSEL(FNOSC_FRC);		// FRC Oscillator 
_FOSC(FCKSM_CSECMD & OSCIOFNC_OFF  & POSCMD_NONE); 
								// Clock Switching is enabled and Fail Safe Clock Monitor is disabled
								// OSC2 Pin Function: OSC2 is Clock Output
								// Primary Oscillator Mode: Disabled


_FWDT(FWDTEN_OFF);              // Watchdog Timer Enabled/disabled by user software


//Begin the Main Fucntion

int main(void)
{
	unsigned int i;
	// Configure Oscillator to operate the device at 40Mhz
	// Fosc= Fin*M/(N1*N2), Fcy=Fosc/2
	// Fosc= 7.37*43/(2*2)=80Mhz for 7.37 input clock
	PLLFBD=41;					// M=43
	CLKDIVbits.PLLPOST=0;		// N1=2
	CLKDIVbits.PLLPRE=0;		// N2=2
	OSCTUN=0;					// Tune FRC oscillator, if FRC is used

	// Disable Watch Dog Timer
	RCONbits.SWDTEN=0;

	// Clock switch to incorporate PLL
	__builtin_write_OSCCONH(0x01);		// Initiate Clock Switch to
										// FRC with PLL (NOSC=0b001)
	__builtin_write_OSCCONL(0x01);		// Start clock switching
	while (OSCCONbits.COSC != 0b001);	// Wait for Clock switch to occur

	// Wait for PLL to lock
	while(OSCCONbits.LOCK!=1);
	//Now PLL is ready
	for(i = 0;i<256;i++)
	{
		RAMBuffer[i] = i;	//Initlize RAMBuffer with some value
							//in case MasterI2C device wants to read
							//before it writes to it.
	}
	i2c1_init();
	while(1)
	{
		//Do your application task	
	}
}
