eberlawrence/bebionic_rebuild/(notices)

Notices in the files:
parts and their libraries:
SparkFun-Connectors: Licensing: Creative Commons ShareAlike 4.0 International - https://creativecommons.org/licenses/by-sa/4.0
m-pad-2.1: License : GNU General Public License version 2 (see bottom)
